GitMasterLOL/cnc-auto-door-cad/images/assm cross section.png

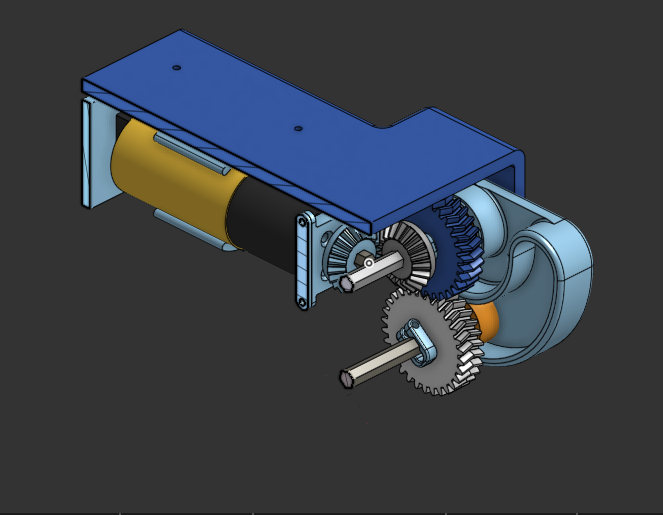
images/assm cross section.png
