GitMasterLOL/cnc-auto-door-cad/images/assm front.png

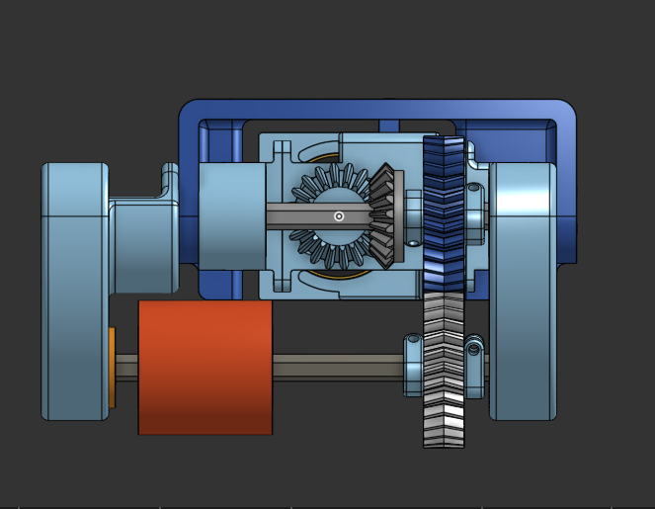
images/assm front.png
