GitMasterLOL/cnc-auto-door-cad/images/assm iso 1.png

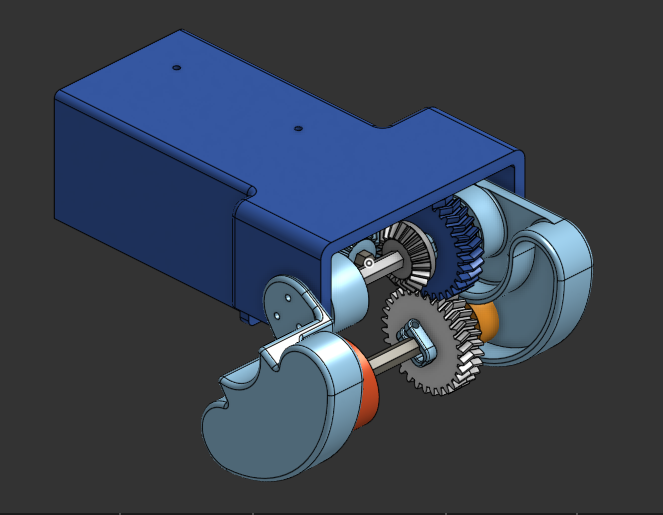
images/assm iso 1.png
