GitMasterLOL/cnc-auto-door-cad/3D_files/00 Assembly.step

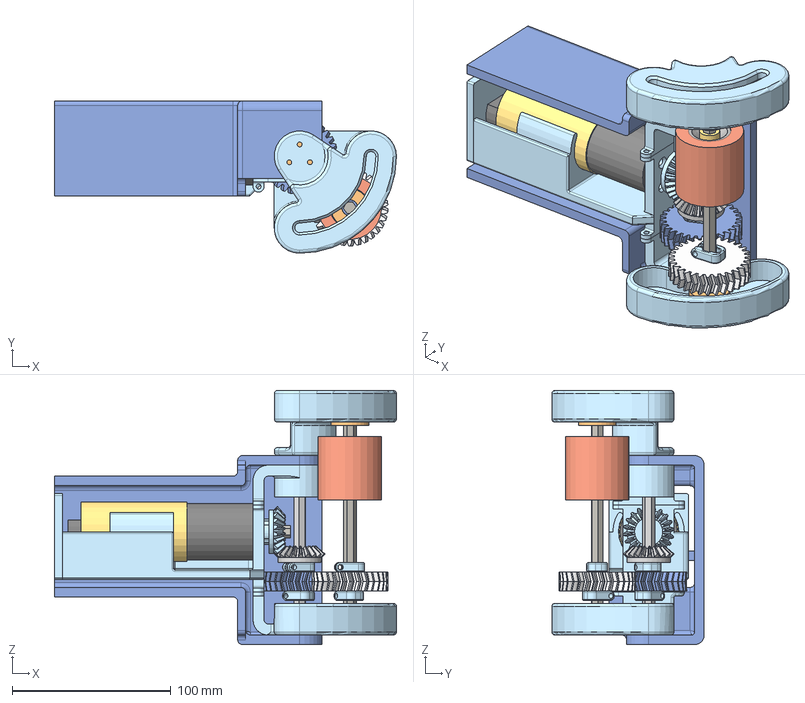
[picture p11: CAD file, 2026-10-10]
3D_files/00 Assembly.step
215.3 x 96.0 x 160.0 mm
shaft collar x 4
Bevel 1.5M 20T 45deg x 2
Helical 1.5M 30T x 2
hex coupling x 4
near slot
motor mount
91 mm shaft
bearing x 4
roller coupling
far slot mount
clip
135 mm shaft
far bearing
roller
motor backplate
motor
