GitMasterLOL/cnc-auto-door-cad/3D_files/Helical 1.5M 30T 1.step

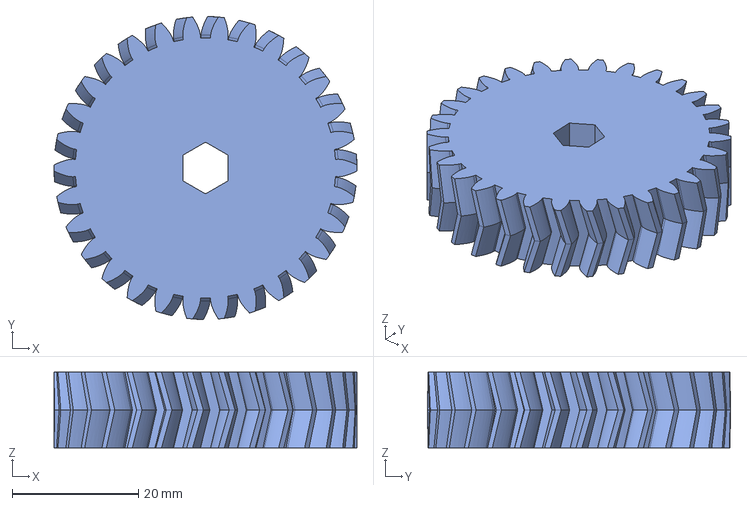
[picture p12: CAD file, 2026-10-10]
3D_files/Helical 1.5M 30T 1.step
48.0 x 48.0 x 12.0 mm
