GitMasterLOL/cnc-auto-door-cad/3D_files/Bevel 1.5M 20T 45deg 1.step

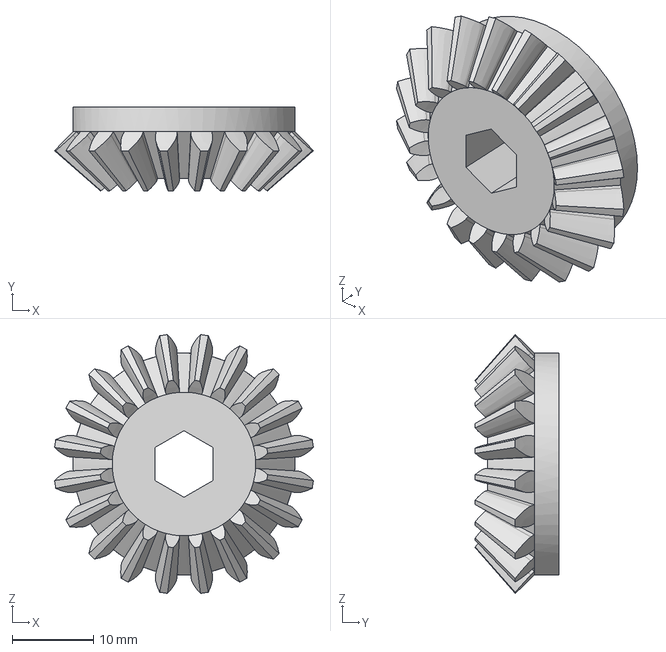
[picture p13: CAD file, 2026-10-10]
3D_files/Bevel 1.5M 20T 45deg 1.step
31.9 x 10.3 x 31.9 mm
